kjoehass/firefly/README.md

# firefly

The goal of this project is to develop a device that can simulate the flash patterns of fireflies. The device will be used to investigate evolution and speciation in fireflies.
