kjoehass/firefly/code/README.md

# Arduino sketch

This code was developed using version 1.8.13 of the Arduino IDE.

Set the IDE preferences so that the default sketchbook is this directory.
