kjoehass/firefly/spec/FireflySpec_2p0.tex

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

\graphicspath{{graphics/}}

\ifpdf\pdfinfo{
  /Title (Firefly Simulator Specification) %FIXME
  /Author (Bucknell University) %FIXME
/Keywords () }
\fi

% load hyperref package first!!
\usepackage{fancyhdr,pageslts}
\pagestyle{fancy}
\fancyhf{}
\fancyhead[L]{Firefly Simulator Specification V2.0}
\fancyfoot[C]{Page \thepage\ of \pageref*{LastPage}}
\usepackage[iso]{datetime}
\fancyfoot[L]{Revised \today}
\pagenumbering{arabic}
\renewcommand\headrulewidth{0pt}

\begin{document}
\section{Overview}

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

\section{References}

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

\section{Definitions}

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

\setlength\extrarowheight{4pt}
\begin{supertabular}{p{1.25in}p{5.25in}}
abort &
    A pushbutton input to the \textit{firefly simulator}. Pressing this button
    causes the simulator to stop any repeated \textit{flashes} or
    \textit{patterns}, and to bring the \textit{illumination level} to 0\% on
    all \textit{channels}.\\
ASCII &
    The American Standard Code for Information Interchange. The letters in
    the English alphabet, the decimal digits, and common punctuation marks are
    assigned a unique 7-bit binary code.\\
channel &
    The \textit{channel} of an \textit{LED} is an integer that specifies
    which physical output connector of the firefly simulator is connected
    to the physical LED. The value of \textit{channel} is an integer and
    shall not be less than 1 and not greater than \textit{max channel}.\\
        &
    Note that the \textit{channel} is not the pin number of any particular
    microcontroller. An implementation of the firefly simulator must perform
    the appropriate mapping of an \textit{LED}'s \textit{channel} to an
    appropriate physical pin on the output device.\\
%delay step&
%    A time interval in a \textit{pattern} when all \textit{LEDs} are dark.
%    A \textit{delay step} is a step in a \textit{pattern} that inserts a time
%    delay but does not cause a flash.\\
down duration & 
    The length of the \textit{ramp down} interval. The \textit{down duration}
    is equal to $t_4 - t_3$, as shown in Fig.\ \ref{fig:FlashPulse}. The
    \textit{down duration} shall be a non-negative integer value with units
    of milliseconds. The value of \textit{down duration} shall not be less
    than 0 or greater than 32\,767.\\
%duty factor &  For a periodic rectangular pulse that has only two possible
%    voltage levels, the \textit{duty factor} is the ratio of the duration of
%    the pulse at its higher voltage divided by the period of the waveform.
%
%    \[ 0.0 \le d_f \le 1.0 \quad \mathrm{ or } \quad 0\% \le d_f \le 100\%\]
event &
    An external event that can be recognized by the \textit{firefly simulator}.
    Details TBD.\\
flash &
    The process of bringing the \textit{illumination level} of an \textit{LED}
    from 0\% to 100\% then back to 0\% illumination. A \textit{flash} consists of
    a \textit{ramp up}, followed by an \textit{on time}, followed by a
    \textit{ramp down}. A \textit{flash} begins at $t_1$ and ends at $t_4$,
    as shown in Fig.\ \ref{fig:FlashPulse}. The interval from $t_1$ to $t_2$
    is the \textit{ramp up}. The interval from $t_2$ to $t_3$ is the \textit{on
    time}.  The interval from $t_3$ to $t_4$ is the \textit{ramp down}. The
    interval from $t_4$ to $t_5$ is the \textit{interpulse interval}.\\
    &
    Note the definition of a \textit{flash} primarily specifies the
    \textit{timing} behavior of the \textit{flash}. The selection of a specific
    physical LED and its \textit{max brightness} are part of the definition
    of an \textit{LED}.\\
flash pattern interval &
    The total time duration of a \textit{pattern}.
    This interval includes the time of all \textit{flashes} in the pattern
    as well as the subsequent time when there are no flashes, as shown in
    Fig.\ \ref{fig:PatternTimeline}. The
    \textit{flash pattern interval} is a parameter of a \textit{pattern}.\\
illumination level &
    The brightness of an \textit{LED} at any given point in time, as a
    percentage of that \textit{LED}'s \textit{max brightness}. The
    \textit{illumination level} and \textit{max brightness} values
    indirectly translate to the average current passing through the physical
    LED.\\
    &
    At any given point in time, the average current for an LED is
\[ I_{AVG} = \frac{illumination\,level}{100} \times \frac{max\,brightness}{100}
\times I_{max}\]\\
interpulse interval &
    The total time duration of a \textit{flash}. This interval includes the
    time when the \textit{LED} is illuminated as well as the subsequent time
    when the \textit{LED} is not illuminated, from $t_1$ to $t_5$ in
    Fig.\ \ref{fig:FlashPulse}. The \textit{interpulse interval} is a parameter
    of a \textit{flash}.\\
message &  A sequence of \textit{message fields}, separated by the
    ASCII comma character (decimal 44) and terminated by either the ASCII Line
    Feed (decimal 10), the ASCII Carriage Return (decimal 13), or both the Line
    Feed and the Carriage Return. There shall not be a comma before the first
    field in a message nor after the last field.\\
message field &  A sequence of one or more ASCII characters from the set of
    letters (\texttt{A} through \texttt{Z} and \texttt{a} through \texttt{z}),
    decimal digits (\texttt{0} through \texttt{9}), and the punctuation
    characters required for a \textit{timestamp} (colon, minus, plus, period).
    A message field shall not include a comma.\\
max brightness & 
    The maximum duty factor of the \textit{pulse-width modulation} signal that
    controls the \textit{illumination level} of an \textit{LED}. The
    \textit{max brightness} is a characteristic of an \textit{LED}. The
    value of \textit{max brightness} is an integer and shall be not less
    than 1 and not greater than 100.\\
max channel & 
    The number of physical \textit{LED} \textit{channels} available on a
    particular implementation of a \textit{firefly simulator}.
    The value of \textit{max channel} shall not be less than 1 or greater
    than 127 for any implementation of a \textit{firefly simulator}.\\
max event &
    The number of unique \textit{event} configurations available on a
    particular implementation of a \textit{firefly simulator}.
    The value of \textit{max event} shall not be less than 0 or greater
    than 127 for any implementation of a \textit{firefly simulator}.\\
max flash & 
    The number of unique \textit{flash} configurations available on a
    particular implementation of a \textit{firefly simulator}.
    The value of \textit{max flash} shall not be less than 1 or greater
    than 127 for any implementation of a \textit{firefly simulator}.\\
max LED & 
    The number of unique \textit{LED} configurations available on a
    particular implementation of a \textit{firefly simulator}.
    The value of \textit{max LED} shall not be less than 1 or greater
    than 127 for any implementation of a \textit{firefly simulator}.\\
max pattern & 
    The number of unique \textit{pattern} configurations available on a
    particular implementation of a \textit{firefly simulator}.
    The value of \textit{max pattern} shall not be less than 1 or greater
    than 127 for any implementation of a \textit{firefly simulator}.\\
on duration &
    The length of the \textit{on time} interval. The \textit{on duration} is
    equal to $t_3 - t_2$, as shown in Fig.\ \ref{fig:FlashPulse}. The value
    of \textit{on duration} shall be a positive, non-zero integer with units
    of milliseconds. The value of \textit{on duration} shall not be less than 1
    or greater than 32\,767.\\
on time &
    The period of time during a \textit{flash} when the \textit{LED} is
    constantly at an illumination level of 100\%.\\
pattern &
    A sequence of up to 16 \textit{flashes}, possibly followed by a period
    of time where there are no \textit{flashes}.
    Note that the definition of a \textit{pattern} specifies only the sequence
    of \textit{flashes} that should occur as well as the total duration of the
    \textit{pattern}.\\
%pulse-width modulation & 
ramp down &
    The process of linearly decreasing the \textit{illumination level} of an
    \textit{LED} from 100\% to 0\%.\\
ramp up &
    The process of linearly increasing the \textit{illumination level} of an
    \textit{LED} from 0\% to 100\%.\\
time stamp &
    A representation of the current date and time used as \textit{message field}.
    The \textit{time stamp} shall conform to ISO 8601. The format of the
    \textit{time stamp} is TBD.\\
up duration &
    The length of the \textit{ramp up} interval. The \textit{up duration}
    is equal to $t_2 - t_1$, as shown in Fig.\ \ref{fig:FlashPulse}. The
    value of \textit{up duration} shall be a non-negative integer with units
    of milliseconds. The value of \textit{up duration} shall not be less than
    0 or greater than 32\,767.\\
\end{supertabular}

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

\section{Resolution and Accuracy}

\subsection{Brightness}

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

\subsection{Time}

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

\section{Configuration Messages}

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

\subsection{\textit{capacity query/capacity response messages}}

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

    & Unique identifier for this message type
    & This field shall contain the lowercase letter '\texttt{c}'.
    \\ \hline
    2            & \textit{time stamp}
    & The current data and time
    & This field is TBD
    \\ \hline
    3            & temperature
    & The current ambient temperature, in degrees Celsius.
    & This field shall contain a decimal integer from 0 to 127.
    \\ \hline
    4            & \textit{max channel}
    & The number of physical LEDs available
    & This field shall contain a decimal integer from 1 to 127.
    \\ \hline
    5            & \textit{max LED}
    & The number of available \textit{LED} definitions
    & This field shall contain a decimal integer from 1 to 127.
    \\ \hline
    6            & \textit{max flash}
    & The number of available \textit{flash} definitions
    & This field shall contain a decimal integer from 1 to 127.
    \\ \hline
    7            & \textit{max event}
    & The number of available \textit{event} definitions
    & This field shall contain a decimal integer from 1 to 127.
    \\ \hline
    8            & \textit{max pattern}
    & The number of available \textit{pattern} definitions
    & This field shall contain a decimal integer from 1 to 127.
    \\ \hline
  \end{tabular}
  \label{tab:CapacityResponse}
\end{table}

\subsection{\textit{LED configuration message}}

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

\subsection{\textit{flash configuration message}}

An \textit{flash configuration message} is sent from the host computer to the
firefly simulator. This message provides the parameters for a single
\textit{flash} of an \textit{LED}, as shown in Table \ref{tab:FlashConfig}.

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

\subsection{\textit{pattern configuration message}}

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

A \textit{pattern} may contain from 1 to 16 flashes. Therefore, field 4 in the
\textit{pattern configuration message} may be repeated to define
the desired \textit{flashes} in the pattern. If the \textit{pattern
configuration message} specifies fewer than 16 \textit{flashes} then the
unspecified \textit{flashes} shall have a default \textit{flash} number of 0
(zero) and will be ignored during execution of the \textit{pattern}.

As an example, the message below could be sent by the host computer in
order to configure the \textit{pattern} shown in Fig.\
\ref{fig:PatternTimeline}. This particular pattern was arbitrarily designated
as pattern 5. It contains four \textit{flashes}, but one of the previously
defined \textit{flashes} was repeated. The total duration of this pattern
(i.e.\ the \textit{flash pattern interval}) is \SI{10}{\second}.\\[12pt]
{\ttfamily
P,5,10000,1,4,7,1\\
}

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

\section{Command and Response Messages}

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

Once the \textit{firefly simulator} has received and started executing a
command message it will not respond to any messages sent by the host computer.
Every command must be terminated by pressing the \textit{abort} button before
the \textit{firefly simulator} will respond to messages from the host computer.

\subsection{\textit{Execute LED message}}

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

\subsection{\textit{Execute flash message}}

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

\subsection{\textit{Execute pattern message}}

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

The \textit{firefly simulator} shall respond to the \textit{execute pattern
message} by sending a \textit{pattern start message} to the host computer,
as shown in Table \ref{tab:PatternStart}. The \textit{pattern start message}
shall be sent when every occurrence of a pattern begins.

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

    & Unique identifier for this message type
    & This field shall contain the lowercase letter '\texttt{p}'.
    \\ \hline
    2            & \textit{time stamp}
    & The current data and time
    & This field is TBD
    \\ \hline
    3            & temperature
    & The current ambient temperature, in degrees Celsius.
    & This field shall contain a decimal integer from 0 to 127.
    \\ \hline
    4            & \textit{pattern}

    & The \textit{pattern} number of the pattern that will be executed.
    & This field shall contain a decimal integer from 1 to 127.
    \\ \hline
  \end{tabular}
  \label{tab:PatternStart}
\end{table}

\subsection{\textit{Execute random pattern message}}

An \textit{Execute random pattern message} is sent from the host computer to the
\textit{firefly simulator}. This message can be used to cause the simulator to
pseudo-randomly select and execute patterns from the set of TBD.

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

\subsection{\textit{Event response message}}

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

    & Unique identifier for this message type
    & This field shall contain the lowercase letter '\texttt{e}'.
    \\ \hline
    2            & \textit{time stamp}
    & The current data and time
    & This field is TBD
    \\ \hline
    3            & temperature
    & The current ambient temperature, in degrees Celsius.
    & This field shall contain a decimal integer from 0 to 127.
    \\ \hline
    4            & \textit{pattern}

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

\section{Revision History}

From version 1.0 to version 2.0:
\begin{compactitem}
  \item Added ISO 8601 to references
  \item Added definitions of terms \textit{abort}, \textit{flash pattern
    interval}, \textit{interpulse interval}, \textit{max event},
    \textit{max LED}, \textit{time stamp}
  \item The term \textit{blink} is replaced with the term \textit{flash}.
  \item Added \textit{time stamp} and \textit{temperature} fields to the
    \textit{capacity response message}
  \item Added examples of typical messages
  \item Definition and configuration message for \textit{pattern} was
    significantly changed.
  \item Removed the repeat count field from all \textit{execute} commands;
    these commands must now be terminated by the \textit{abort} 
  \item Updated diagram of \textit{flash} timing to include \textit{interpulse
        interval}.
  \item Updated diagram of \textit{pattern} timing to include \textit{flash
        pattern interval}.
  \item Added definition of \textit{start pattern message}.
\end{compactitem}
\end{document}
