kjoehass/firefly/spec/FireflySpec_2p0.pdf

Firefly Simulator Specification V2.0

## 1 Overview

This document provides specifications for a firefly simulator. This device is intended to simulate the light displays of common fireflies, such as Photinus pyralis. The firefly simulator will provide means to control the brightness, duration, and other relevant parameters of the simulated light display. Light-emitting diodes (LEDs) will be used as the light source, and the color of the display can be altered by connecting different LED types to the simulator.
The firefly simulator can be configured via commands issued to it from a host computer, as shown in Fig. 1. The physical link between the host computer and the firefly simulator is an asynchronous serial communications interface, which can be accomplished with a common and inexpensive USB adapter. The firefly simulator also can return status information to the host computer via the same interface.
Once configured, the firefly simulator can be used in a stand-alone mode, without requiring a connection to a host computer. Pushbuttons on the firefly simulator can be used to activate light displays that were previously configured. When in the stand-alone mode, the simulator can be powered by a USB powerbank.

Fire y Simulator; Host; LEDs; Computer; Pushbuttons; Test Specimen; USB

Figure 1: Firefly Simulator Block Diagram

This document describes the minimum required functionality of the firefly simulator. Possible future enhancements to the simulator include:
- The ability to sense the behavior of a test specimen and use that behavior to modify the parameters of a light display.
- The ability to record information about simulator activity on non-volatile memory, such as a removable Secure Digital (SD) memory card.
- The addition of a real-time clock (RTC) to the firefly simulator so that timestamps can be added to response messages from the simulator to the host computer.

## 2 References

1. IEEE Standard for Transitions, Pulses, and Related Waveforms, IEEE Standard 181, 2011.
2. Data elements and interchange formats – Information interchange – Representation of dates and times, ISO 8601

## 3 Definitions

abort | A pushbutton input to the firefly simulator. Pressing this button causes the simulator to stop any repeated flashes or patterns, and to bring the illumination level to 0% on all channels.
Revised 2019-02-07 | Page 1 of 9

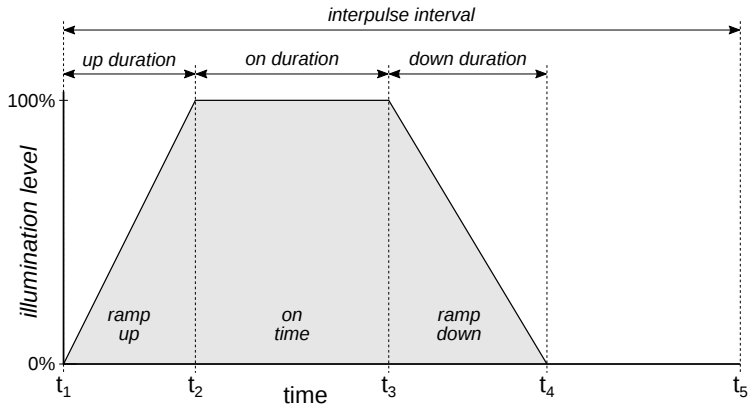
[picture p10: figure]
0%illumination level; time; ramp up; on time; ramp down; up duration; on duration; down duration; interpulse interval

Figure 2: flash waveform

ASCII | The American Standard Code for Information Interchange. The letters in the English alphabet, the decimal digits, and common punctuation marks are assigned a unique 7-bit binary code.
channel | The channel of an LED is an integer that specifies which physical output connector of the firefly simulator is connected to the physical LED. The value of channel is an integer and shall not be less than 1 and not greater than max channel.
| Note that the channel is not the pin number of any particular microcontroller. An imple- mentation of the firefly simulator must perform the appropriate mapping of an LED’s channel to an appropriate physical pin on the output device.
down duration | The length of the ramp down interval. The down duration is equal to t4 −t3, as shown in Fig. 2. The down duration shall be a non-negative integer value with units of mil- liseconds. The value of down duration shall not be less than 0 or greater than 32 767.
event | An external event that can be recognized by the firefly simulator. Details TBD.
flash | The process of bringing the illumination level of an LED from 0% to 100% then back to 0% illumination. A flash consists of a ramp up, followed by an on time, followed by a ramp down. A flash begins at t1 and ends at t4, as shown in Fig. 2. The interval from t1 to t2 is the ramp up. The interval from t2 to t3 is the on time. The interval from t3 to t4 is the ramp down. The interval from t4 to t5 is the interpulse interval.
| Note the definition of a flash primarily specifies the timing behavior of the flash. The selection of a specific physical LED and its max brightness are part of the definition of an LED.
flash pattern interval | The total time duration of a pattern. This interval includes the time of all flashes in the pattern as well as the subsequent time when there are no flashes, as shown in Fig. 3. The flash pattern interval is a parameter of a pattern.
illumination level | The brightness of an LED at any given point in time, as a percentage of that LED’s max brightness. The illumination level and max brightness values indirectly translate to the average current passing through the physical LED.
| At any given point in time, the average current for an LED is

IAV G =

illuminationlevel
100

×

max brightness
100

×Imax

interpulse interval | The total time duration of a flash. This interval includes the time when the LED is illuminated as well as the subsequent time when the LED is not illuminated, from t1 to t5 in Fig. 2. The interpulse interval is a parameter of a flash.
message | A sequence of message fields, separated by the ASCII comma character (decimal 44) and terminated by either the ASCII Line Feed (decimal 10), the ASCII Carriage Return (decimal 13), or both the Line Feed and the Carriage Return. There shall not be a comma before the first field in a message nor after the last field.
message field | A sequence of one or more ASCII characters from the set of letters (A through Z and a through z), decimal digits (0 through 9), and the punctuation characters required for a timestamp (colon, minus, plus, period). A message field shall not include a comma.
max brightness | The maximum duty factor of the pulse-width modulation signal that controls the illu- mination level of an LED. The max brightness is a characteristic of an LED. The value of max brightness is an integer and shall be not less than 1 and not greater than 100.
max channel | The number of physical LED channels available on a particular implementation of a firefly simulator. The value of max channel shall not be less than 1 or greater than 127 for any implementation of a firefly simulator.
max event | The number of unique event configurations available on a particular implementation of a firefly simulator. The value of max event shall not be less than 0 or greater than 127 for any implementation of a firefly simulator.
max flash | The number of unique flash configurations available on a particular implementation of a firefly simulator. The value of max flash shall not be less than 1 or greater than 127 for any implementation of a firefly simulator.
max LED | The number of unique LED configurations available on a particular implementation of a firefly simulator. The value of max LED shall not be less than 1 or greater than 127 for any implementation of a firefly simulator.
max pattern | The number of unique pattern configurations available on a particular implementation of a firefly simulator. The value of max pattern shall not be less than 1 or greater than 127 for any implementation of a firefly simulator.
on duration | The length of the on time interval. The on duration is equal to t3−t2, as shown in Fig. 2. The value of on duration shall be a positive, non-zero integer with units of milliseconds. The value of on duration shall not be less than 1 or greater than 32 767.
on time | The period of time during a flash when the LED is constantly at an illumination level of 100%.
pattern | A sequence of up to 16 flashes, possibly followed by a period of time where there are no flashes. Note that the definition of a pattern specifies only the sequence of flashes that should occur as well as the total duration of the pattern.
ramp down | The process of linearly decreasing the illumination level of an LED from 100% to 0%.
ramp up | The process of linearly increasing the illumination level of an LED from 0% to 100%.
time stamp | A representation of the current date and time used as message field. The time stamp shall conform to ISO 8601. The format of the time stamp is TBD.
up duration | The length of the ramp up interval. The up duration is equal to t2 −t1, as shown in Fig.
2. The value of up duration shall be a non-negative integer with units of milliseconds.
| The value of up duration shall not be less than 0 or greater than 32 767.

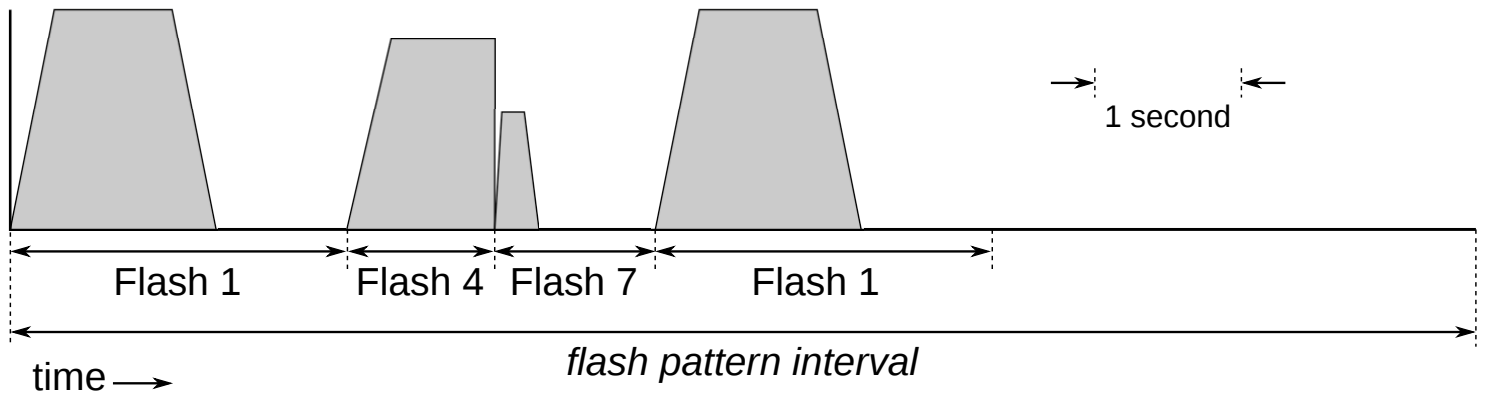
[picture p11: figure]
time; Flash 1; flash pattern interval; Flash 4 Flash 7; 1 second

Figure 3: Example pattern timeline

## 4 Resolution and Accuracy

### 4.1 Brightness

The firefly simulator does not directly control the brightness of a physical LED. Instead, the simulator controls the average current provided to the LED. The simulator’s configuration messages allow the actual average current (IAV G) of an LED to be specified with a resolution of ±1% of the maximum available current (IMAX ). The maximum available current, and the precision which with the current can be specified, will be determined by the circuitry associated with a given physical LED and need not be the same for all LEDs.

### 4.2 Time

Values that represent time shall have units of milliseconds and a resolution of 1 ms. The accuracy of all pulse durations and time delays generated by the firefly simulator over an interpulse interval shall have a maximum error of ±10 ms. The cumulative timing error over a flash pattern interval shall not exceed 200 ms.

## 5 Configuration Messages

The firefly simulator is configured via a serial communications interface to a host computer. The host computer can set the values of all parameters for LEDs, flashes, and patterns. A unique configuration message format is specified for configuring an LED, configuring a flash, or configuring a pattern.

### 5.1 capacity query/capacity response messages

The capacity query message can be used by the host computer to determine the capabilities of a firefly simulator.

Table 1: Definition of the capacity query message
Field Number | Field Name | Description | Format
1 | Header | Unique first character for an capacity query message | This field shall be the uppercase letter ‘C’.

The firefly simulator will respond to the capacity query message by sending a capacity response message to the host computer.

Table 2: Definition of the capacity response message
Field Number | Field Name | Description | Format
1 | message type | Unique identifier for this message type | This field shall contain the lowercase letter ’c’.
2 | time stamp | The current data and time | This field is TBD
3 | temperature | The current ambient temperature, in degrees Celsius. | This field shall contain a decimal in-teger from 0 to 127.
4 | max channel | The number of physical LEDs avail-able | This field shall contain a decimal in-teger from 1 to 127.
5 | max LED | The number of available LED defini-tions | This field shall contain a decimal in-teger from 1 to 127.
6 | max flash | The number of available flash defini-tions | This field shall contain a decimal in-teger from 1 to 127.
7 | max event | The number of available event defini-tions | This field shall contain a decimal in-teger from 1 to 127.
8 | max pattern | The number of available pattern def-initions | This field shall contain a decimal in-teger from 1 to 127.

### 5.2 LED configuration message

An LED configuration message is sent from the host computer to the firefly simulator. Every LED configuration message shall contain four message fields, as shown in Table 3.
As an example, the three messages below could be sent by the host computer in order to configure three LEDs. This example assumes that LED 2 uses physical channel 1 and has a max brightness of 100%. LEDs 3 and 5 use the same physical channel (i.e. the same physical LED) but with different levels of max brightness: 87% and 53%, respectively. The LED numbers, channel numbers, and max brightness levels shown here were chosen arbitrarily; the purpose of this example is only to illustrate the syntax of the LED configuration message.

L,2,1,100
L,3,6,87
L,5,6,53

Table 3: Definition of the LED configuration message
Field Number | Field Name | Description | Format
1 | Header | Unique first character for an LED configuration message | This field shall be the uppercase letter ‘L’.
2 | LED number | A unique identifier for each LED def-inition | This field shall contain a decimal in-teger from 1 to max LED.
3 | LED channel | The physical channel associated with this LED | This field shall contain a decimal in-teger from 1 to max channel.
4 | max brightness | The maximum brightness level for the LED | This field shall contain a decimal in-teger from 1 to 100.

### 5.3 flash configuration message

An flash configuration message is sent from the host computer to the firefly simulator. This message provides the parameters for a single flash of an LED, as shown in Table 4.
As an example, the three messages below could be sent by the host computer in order to configure the three flashes shown in Fig. 3. This example assumes that flash 1 uses LED 2, flash 4 uses LED 3, and flash 7 uses LED 5. The flash and LED numbers were chosen arbitrarily; the purpose of this example is only to illustrate the syntax of the flash configuration message.

F,1,2,300,800,300,2300
F,4,3,300,700,0,1000
F,7,5,50,150,100,1100

Table 4: Definition of the flash configuration message
Field Number | Field Name | Description | Format
1 | Header | Unique first character for a flash con-figuration message | This field shall be the uppercase letter ‘F’.
2 | flash number | A unique identifier for each flash def-inition | This field shall contain a decimal in-teger from 1 to max flash.
3 | LED number | Identifier for the LED to be illumi-nated in this flash | This field shall contain a decimal in-teger from 1 to max channel.
4 | up duration | The duration of the ramp up in mil-liseconds | This field shall contain a decimal in-teger from 0 to 32 767.
5 | on duration | The duration of the on time in mil-liseconds | This field shall contain a decimal in-teger from 1 to 32 767.
6 | down duration | The duration of the ramp down in milliseconds | This field shall contain a decimal in-teger from 0 to 32 767.
7 | interpulse inter-val | The duration of the entire flash in milliseconds | This field shall contain a decimal in-teger from 0 to 32 767.

### 5.4 pattern configuration message

An pattern configuration message is sent from the host computer to the firefly simulator. This message provides the parameters for a single pattern of one or more flashes, as shown in Table 5. Note that the same flash may be repeated within a pattern.
A pattern may contain from 1 to 16 flashes. Therefore, field 4 in the pattern configuration message may be repeated to define the desired flashes in the pattern. If the pattern configuration message specifies fewer than 16 flashes then the unspecified flashes shall have a default flash number of 0 (zero) and will be ignored during execution of the pattern.
As an example, the message below could be sent by the host computer in order to configure the pattern shown in Fig. 3. This particular pattern was arbitrarily designated as pattern 5. It contains four flashes, but one of the previously defined flashes was repeated. The total duration of this pattern (i.e. the flash pattern interval) is 10 s.

P,5,10000,1,4,7,1

Table 5: Definition of the pattern configuration message
Field Number | Field Name | Description | Format
1 | Header | Unique first character for a pattern configuration message | This field shall be the uppercase letter ‘P’.
2 | pattern number | A unique identifier for each pattern definition | This field shall be a decimal integer from 1 to max pattern.
3 | flash pattern in-terval number | The total duration of the pattern in milliseconds | This field shall contain a decimal in-teger from 0 to 32 767.
4 | flash list | The number of a flash to be included in the pattern. | This field shall be a decimal integer from 1 to max flash.

## 6 Command and Response Messages

The host computer can command the firefly simulator to turn on an LED at a specified illumination level, repeatedly execute a specific flash, repeatedly execute a specific pattern, or repeatedly execute a set of available patterns in a pseudorandom order.
Once the firefly simulator has received and started executing a command message it will not respond to any messages sent by the host computer. Every command must be terminated by pressing the abort button before the firefly simulator will respond to messages from the host computer.

### 6.1 Execute LED message

An Execute LED message is sent from the host computer to the firefly simulator. This message can be used to turn an LED on for testing or calibration purposes. Every Execute LED message shall contain three message fields, as shown in Table 6.

Table 6: Definition of the Execute LED message
Field Number | Field Name | Description | Format
1 | Header | Unique first two characters for an Ex-ecute LED message | This field shall be the uppercase let-ters ‘XL’.
2 | LED channel | A unique identifier for a physical LED | This field shall contain a decimal in-teger from 1 to max channel.
3 | illumination level | Sets a constant value for the illumi-nation level of the LED | This field shall contain a decimal in-teger from 0 to 100. A value of 100 causes the illumination level of the LED to be set at a constant value of 100% (of the LED’s max brightness level). A ‘0’ shall cause the illumina-tion level of the LED to be set at 0% (completely dark).

### 6.2 Execute flash message

An Execute flash message is sent from the host computer to the firefly simulator. This message can be used to cause the firefly simulator to repeatedly execute a specific flash. Every Execute flash message shall contain two message fields, as shown in Table 7.

Table 7: Definition of the Execute flash message
Field Number | Field Name | Description | Format
1 | Header | Unique first two characters for an Ex-ecute flash message | This field shall be the uppercase let-ters ‘XF’.
2 | flash number | A unique identifier for a flash | This field shall contain a decimal in-teger from 1 to max flash.

### 6.3 Execute pattern message

An Execute pattern message is sent from the host computer to the firefly simulator. This message can be used to cause the firefly simulator to repeatedly execute a specific pattern. Every Execute pattern message shall contain two message fields, as shown in Table 8.

Table 8: Definition of the Execute pattern message
Field Number | Field Name | Description | Format
1 | Header | Unique first two characters for an Ex-ecute pattern message | This field shall be the uppercase let-ters ‘XP’.
2 | pattern number | A unique identifier for a pattern | This field shall contain a decimal in-teger from 1 to max pattern.

The firefly simulator shall respond to the execute pattern message by sending a pattern start message to the host computer, as shown in Table 9. The pattern start message shall be sent when every occurrence of a pattern begins.

Table 9: Definition of the pattern start message
Field Number | Field Name | Description | Format
1 | message type | Unique identifier for this message type | This field shall contain the lowercase letter ’p’.
2 | time stamp | The current data and time | This field is TBD
3 | temperature | The current ambient temperature, in degrees Celsius. | This field shall contain a decimal in-teger from 0 to 127.
4 | pattern | The pattern number of the pattern that will be executed. | This field shall contain a decimal in-teger from 1 to 127.

### 6.4 Execute random pattern message

An Execute random pattern message is sent from the host computer to the firefly simulator. This message can be used to cause the simulator to pseudo-randomly select and execute patterns from the set of TBD.

The firefly simulator shall send a pattern start message to the host computer before beginning each pattern.

Table 10: Definition of the Execute random pattern message
Field Number | Field Name | Description | Format
1 | Header | Unique first two characters for an Ex-ecute random pattern message | This field shall be the uppercase let-ters ‘XR’.

### 6.5 Event response message

The firefly simulator shall respond to an event by sending an event response message to the host computer, as shown in Table 11.

Table 11: Definition of the event response message
Field Number | Field Name | Description | Format
1 | message type | Unique identifier for this message type | This field shall contain the lowercase letter ’e’.
2 | time stamp | The current data and time | This field is TBD
3 | temperature | The current ambient temperature, in degrees Celsius. | This field shall contain a decimal in-teger from 0 to 127.
4 | pattern | The event number of the event that occurred. | This field shall contain a decimal in-teger from 1 to 127.

## 7 Revision History

From version 1.0 to version 2.0:
- Added ISO 8601 to references
- Added definitions of terms abort, flash pattern interval, interpulse interval, max event, max LED, time stamp
- The term blink is replaced with the term flash.
- Added time stamp and temperature fields to the capacity response message
- Added examples of typical messages
- Definition and configuration message for pattern was significantly changed.
- Removed the repeat count field from all execute commands; these commands must now be terminated by the abort
- Updated diagram of flash timing to include interpulse interval.
- Updated diagram of pattern timing to include flash pattern interval.
- Added definition of start pattern message.
