kjoehass/firefly/spec/graphics/Flashes_BlinkPulse.pdf

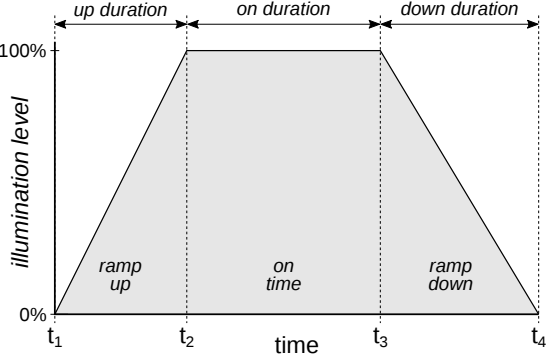
[picture p12: figure]
0%illumination level; time; ramp up; on time; ramp down; up duration; on duration; down duration
