kjoehass/firefly/spec/graphics/Flashes_PatternTimeline.pdf

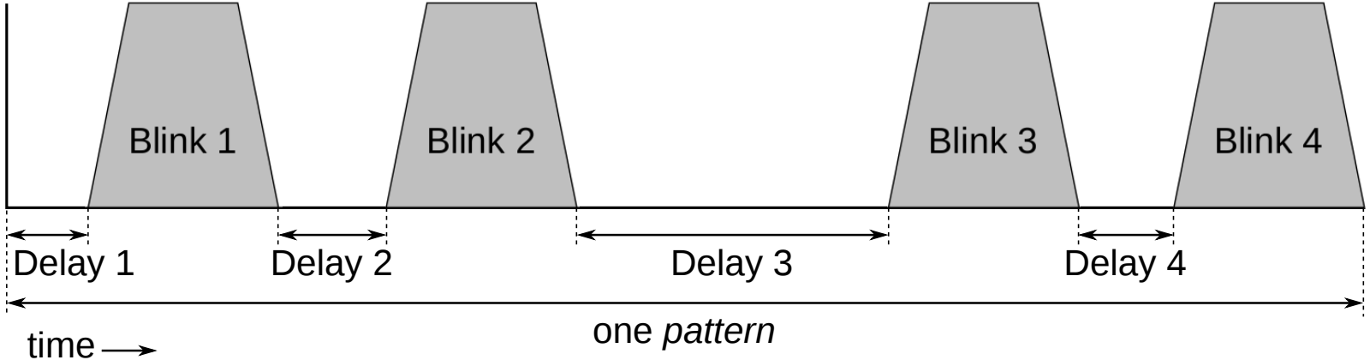
[picture p13: page 1]

time

Delay 1 | Delay 2 | Delay 3 | Delay 4
| | one pattern
