kjoehass/firefly/spec/graphics/Flashes_PatternTimeline2.pdf

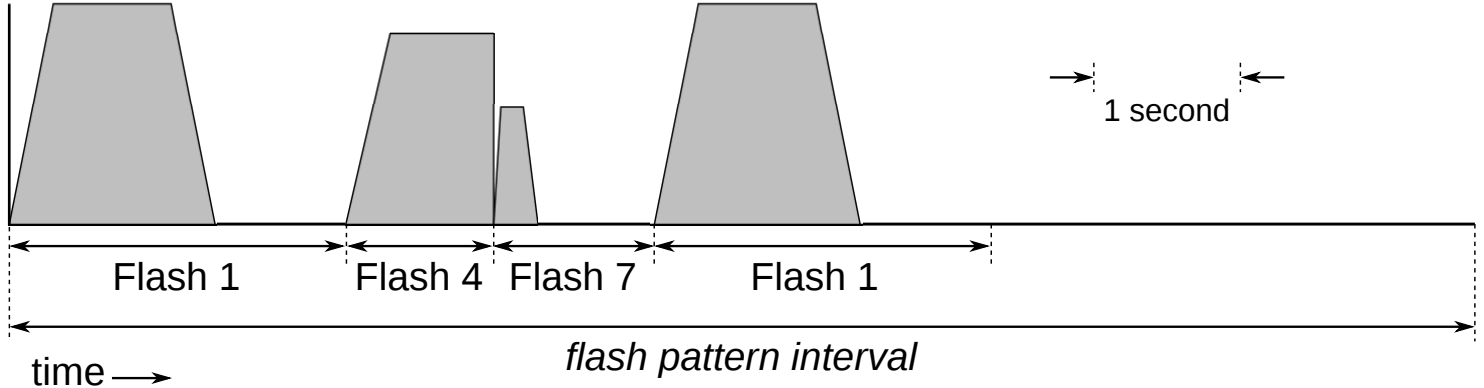
[picture p14: figure]
time; Flash 1; flash pattern interval; Flash 4 Flash 7; 1 second
