kjoehass/firefly/ConstCurrPTH/ConstCurrPTHBottom.png

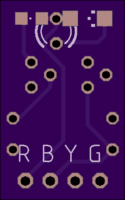
ConstCurrPTH/ConstCurrPTHBottom.png
