kjoehass/firefly/ConstCurrPTH/ConstCurrPTHTop.png

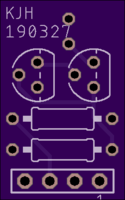
ConstCurrPTH/ConstCurrPTHTop.png
