kjoehass/firefly/spec/graphics/FlashFSM_1.png

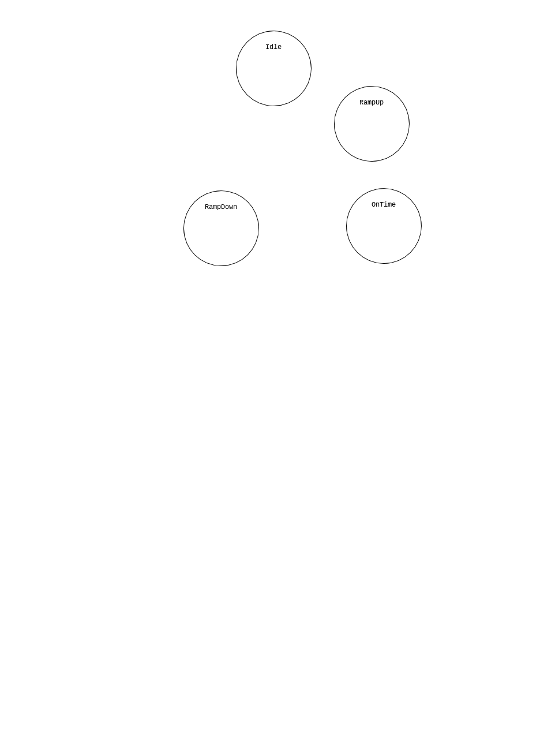
spec/graphics/FlashFSM_1.png
