kjoehass/firefly/spec/graphics/Flashes_BlockDiagram.pdf

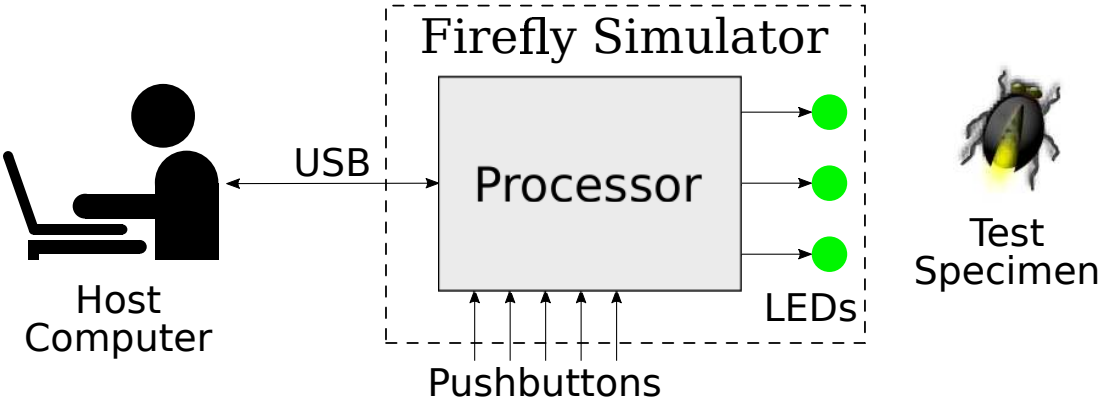
[picture p20: page 1]
Fire y Simulator; Host; LEDs; Computer; Pushbuttons; Test Specimen; USB
