kjoehass/firefly/spec/graphics/Flashes.svgz.pdf

## 0%illumination level

## 0%illumination level

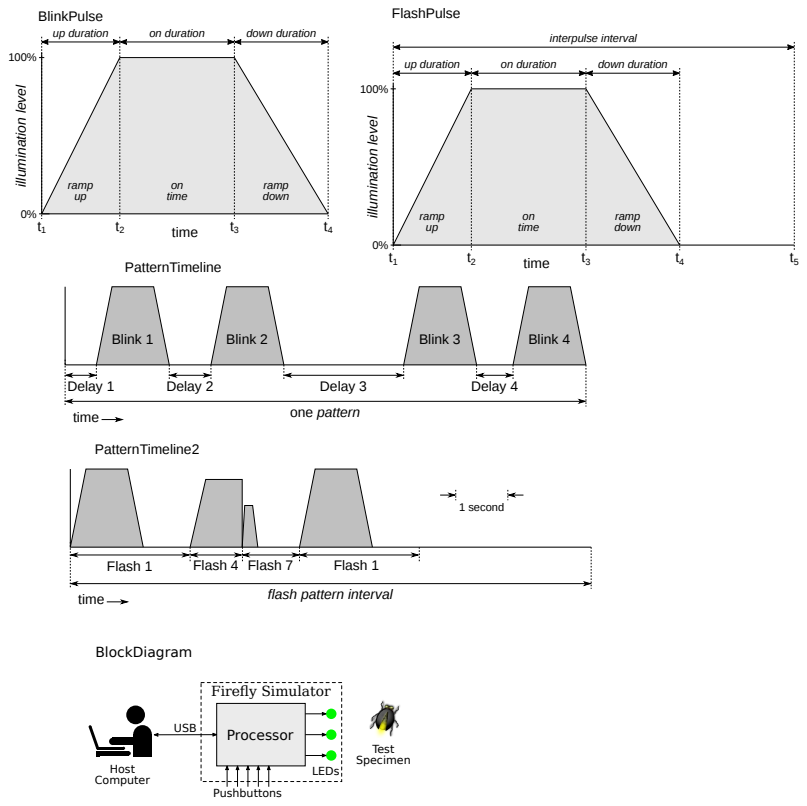
[picture p21: page 1]
BlinkPulse; time; Blink 1; Blink 2; Blink 3; Blink 4; Delay 1; Delay 2; Delay 3; Delay 4; one pattern; PatternTimeline; ramp up; on time; ramp down; up duration; on duration; down duration; Firefly Simulator; LEDs; Processor; Host Computer; Pushbuttons; Test Specimen; USB; BlockDiagram; FlashPulse; interpulse interval; Flash 1; Flash 4 Flash 7; 1 second; PatternTimeline2

flash pattern interval
