kjoehass/firefly/ConstCurrPTH/ConstCurrPTH_V1.brd

## EAGLE design ConstCurrPTH/ConstCurrPTH_V1.brd (2019-05-01)

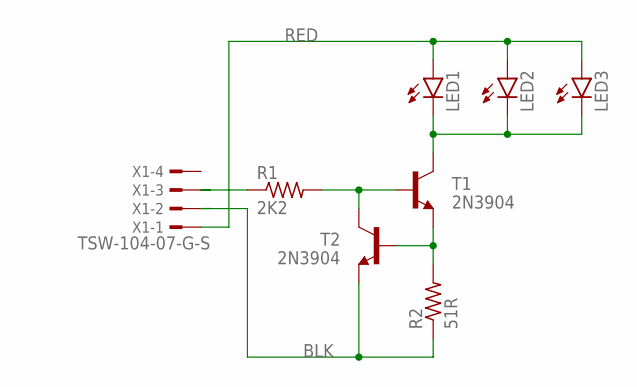
[picture p25: schematic ConstCurrPTH_V1.sch]

Parts:
LED1: LED3MM
LED2: LEDCHIPLED_0805; CHIPLED_0805
LED3: LEDCHIPLED_1206; CHIPLED_1206
R1: 2K2; 0207/10
R2: 51R; 0207/10
T1, T2: 2N3904; TO92
X1: TSW-104-07-G-S; TSW-104-XX-G-S

Connections:
BLK: R2.1, T2.3 (E), X1.2
unnamed: LED1.K (C), LED2.C, LED3.C, T1.1 (C)
unnamed: R2.2, T1.3 (E), T2.2 (B)
unnamed: R1.2, T1.2 (B), T2.1 (C)
unnamed: R1.1, X1.3
RED: LED1.A, LED2.A, LED3.A, X1.1

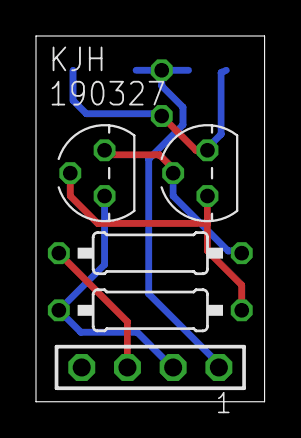
[picture p26: board ConstCurrPTH_V1.brd from above]

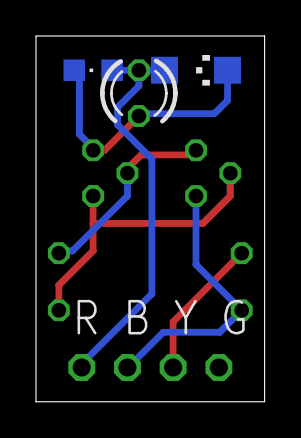
[picture p27: board ConstCurrPTH_V1.brd from below]

Board: 2 copper layers, 12.7 x 20.3 mm, 8 parts (3 on the bottom side), 6 nets.
