kjoehass/firefly/RJ11Breakout/RJ11Breakout.brd

## EAGLE design RJ11Breakout/RJ11Breakout.brd (2019-05-01)

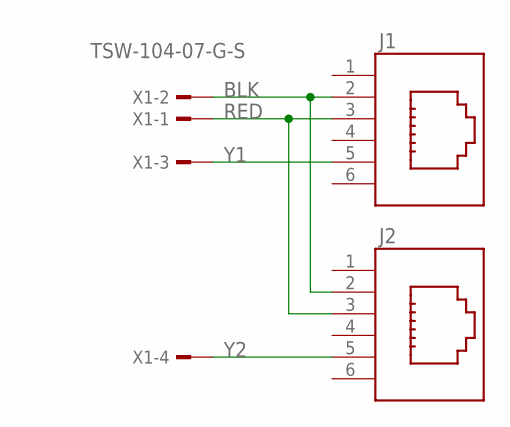
[picture p28: schematic RJ11Breakout.sch]

Parts:
J1, J2: 615006138421
X1: TSW-104-07-G-S; TSW-104-XX-G-S

Connections:
BLK: J1.2 (5), J2.2 (5), X1.2
RED: J1.3 (4), J2.3 (4), X1.1
Y1: J1.5 (2), X1.3
Y2: J2.5 (2), X1.4

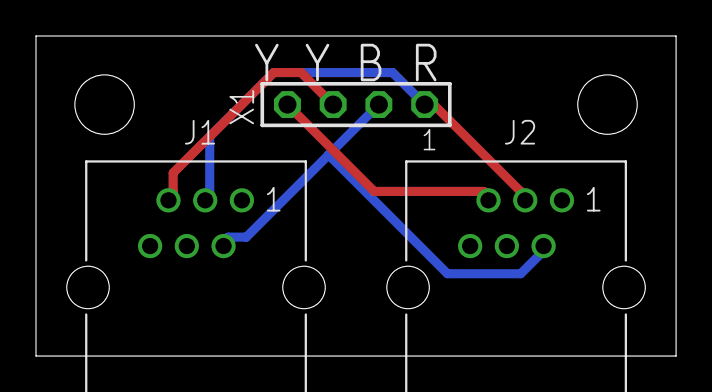
[picture p29: board RJ11Breakout.brd from above]

Board: 2 copper layers, 35.6 x 17.8 mm, 3 parts (0 on the bottom side), 4 nets.
