kjoehass/firefly/FireflyShield/FireflyShield.brd

## EAGLE design FireflyShield/FireflyShield.brd (2019-05-01)

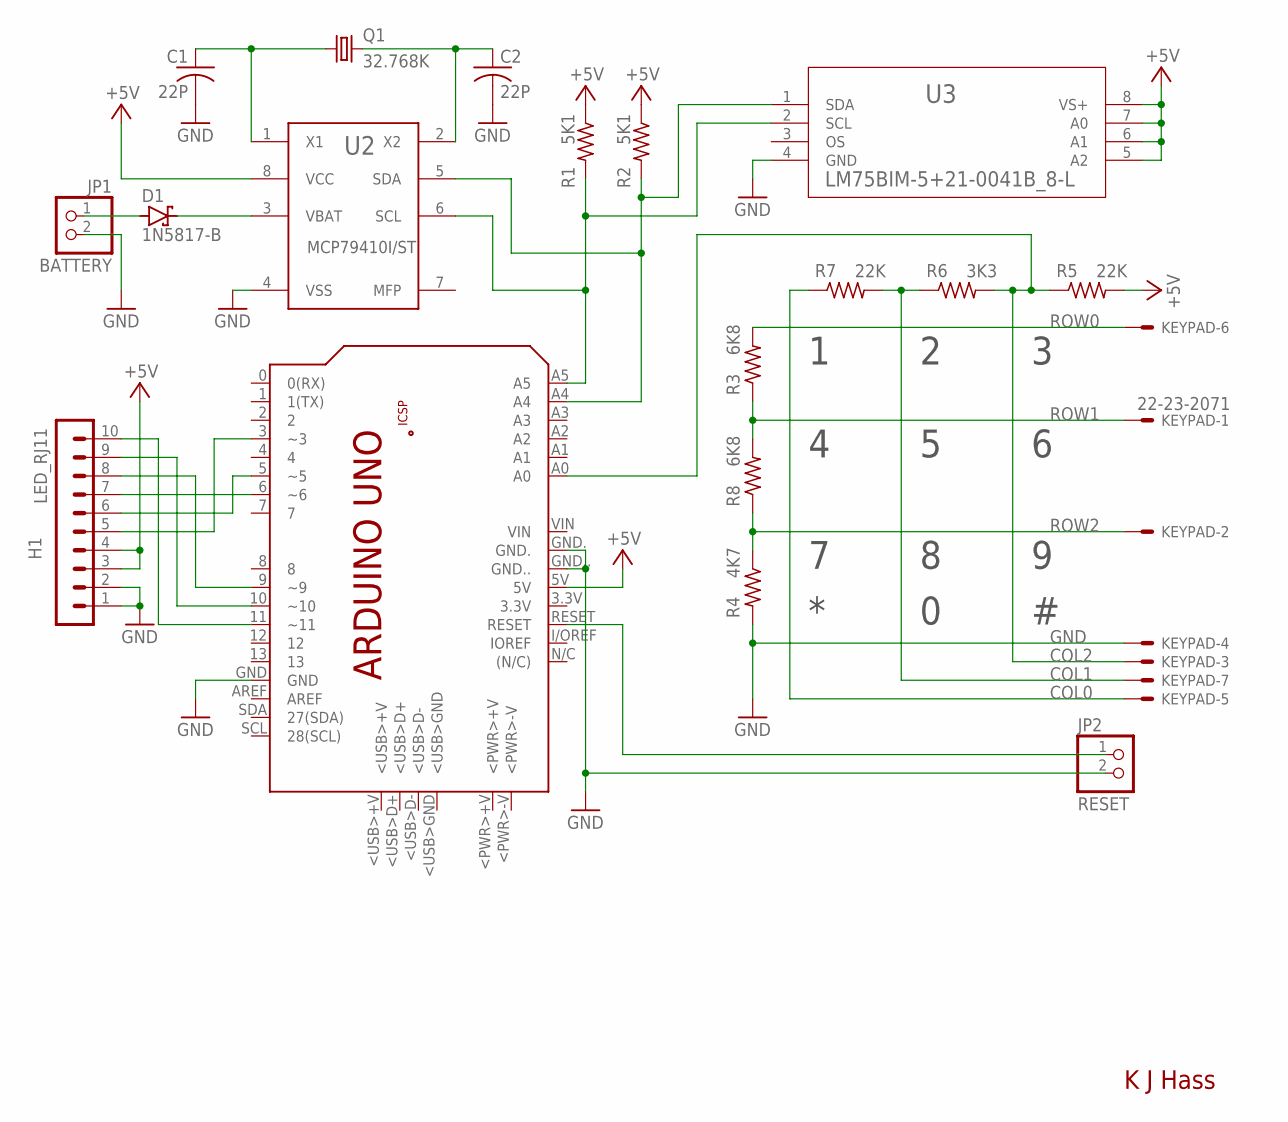
[picture p30: schematic FireflyShield.sch]

Parts:
C1, C2: 22P; C0805
D1: 1N5817-B; DO41-7.6
H1: LED_RJ11; MA10-1
JP1: BATTERY; 1X02
JP2: RESET; 1X02
KEYPAD: 22-23-2071
PCB1: ARDUINO_UNO
Q1: 32.768K; TC26V
R1, R2: 5K1; 0207/10
R3, R8: 6K8; 0207/10
R4: 4K7; 0207/10
R5, R7: 22K; 0207/10
R6: 3K3; 0207/10
U2: MCP79410I/ST; TSSOP8_4MM4
U3: LM75BIM-5+21-0041B_8-L; 21-0041B_8-L

Connections:
+5V: H1.3, H1.4, PCB1.5V, R1.1, R2.1, R5.2, U2.8 (VCC), U3.5 (A2), U3.6 (A1), U3.7 (A0), U3.8 (VS+)
COL0: KEYPAD.5, R7.1
COL1: KEYPAD.7, R6.1, R7.2
COL2: KEYPAD.3, PCB1.A0, R5.1, R6.2
GND: C1.2, C2.2, H1.1, H1.2, JP1.2, JP2.2, KEYPAD.4, PCB1.GND, PCB1.GND., PCB1.GND.., R4.2, U2.4 (VSS), U3.4 (GND)
unnamed: PCB1.A5, R1.2, U2.6 (SCL), U3.2 (SCL)
unnamed: H1.5, PCB1.3 (~3)
unnamed: H1.6, PCB1.5 (~5)
unnamed: H1.7, PCB1.6 (~6)
unnamed: H1.8, PCB1.9 (~9)
unnamed: H1.9, PCB1.10 (~10)
unnamed: H1.10, PCB1.11 (~11)
unnamed: JP2.1, PCB1.RESET
unnamed: C1.1, Q1.1, U2.1 (X1)
unnamed: C2.1, Q1.2, U2.2 (X2)
unnamed: D1.C, U2.3 (VBAT)
unnamed: D1.A, JP1.1
ROW0: KEYPAD.6, R3.2
ROW1: KEYPAD.1, R3.1, R8.2
ROW2: KEYPAD.2, R4.1, R8.1
SCL: PCB1.A4, R2.2, U2.5 (SDA), U3.1 (SDA)

Notes on the sheet:
K J Hass

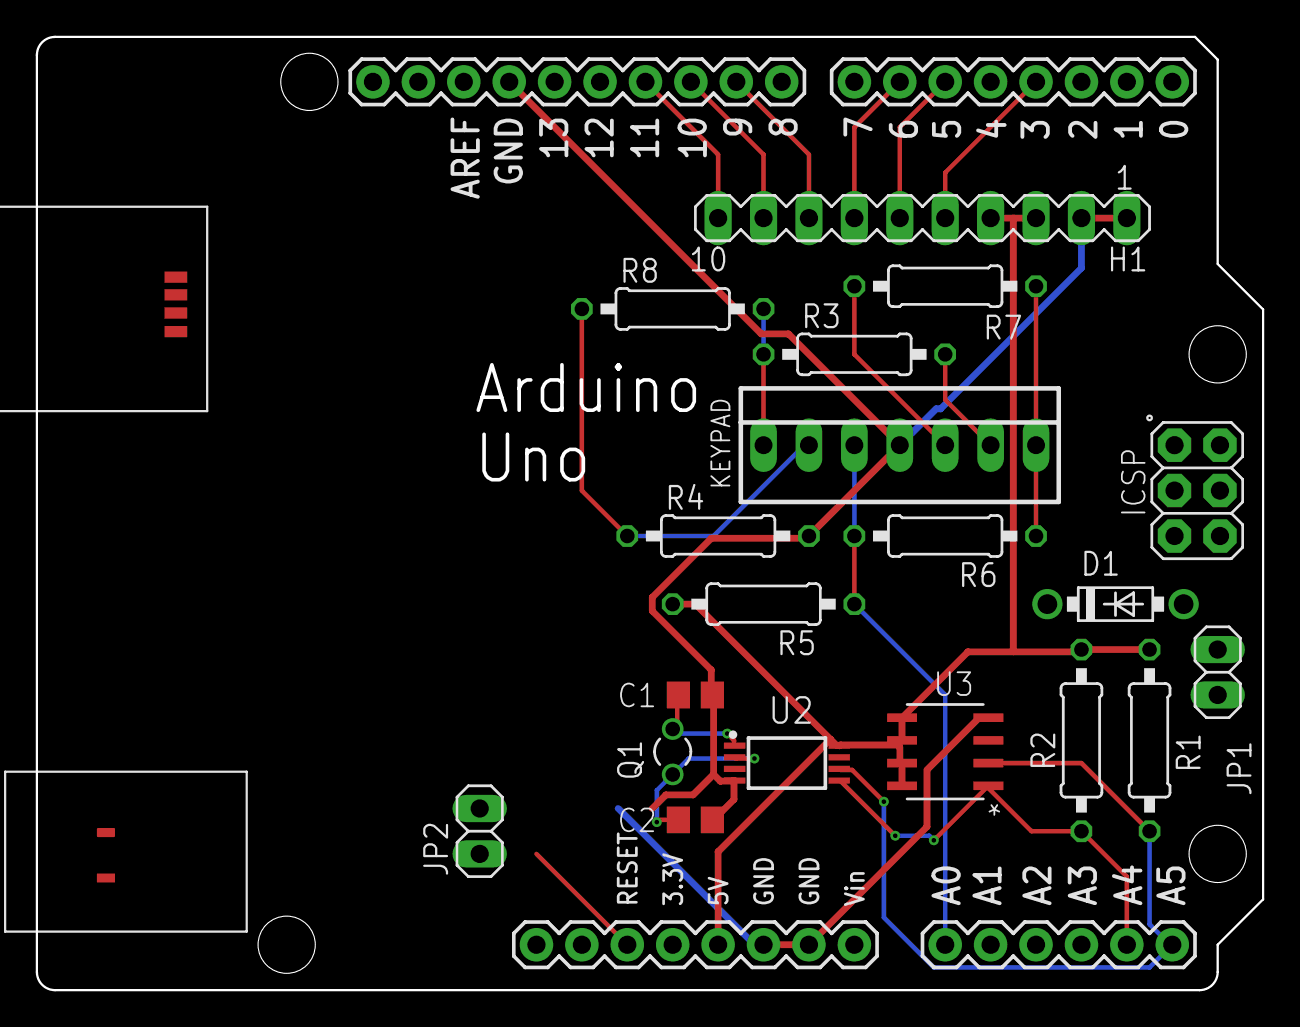
[picture p31: board FireflyShield.brd from above]

Board: 2 copper layers, 68.6 x 53.3 mm, 19 parts (0 on the bottom side), 21 nets.
