kjoehass/firefly/code/Firefly.h

/**
   @file Firefly.h

   @brief  Global configuration options for the firefly simulator

   @author Joe Hass and Matt Turconi
   @date Created: 2019-04-14T10:51:46-0400
   @date Last modified: 2019-09-04T08:05:27-0400

   @copyright This program is free software: you can redistribute it and/or
   modify it under the terms of the GNU General Public License as published by
   the Free Software Foundation, either version 3 of the License, or (at your
   option) any later version.

   @copyright This program is distributed in the hope that it will be useful,
   but WITHOUT ANY WARRANTY; without even the implied warranty of
   MERCHANTABILITY or FITNESS FOR A PARTICULAR PURPOSE. See the GNU General
   Public License for more details.

*/
#ifndef _FIREFLY_H
#define _FIREFLY_H

/**
  @def   ARDUINO_IS_UNO
  @brief Compile for an UNO with 6 PWM channels and 2KiB EEPROM
*/
#define ARDUINO_IS_UNO  1
#define ARDUINO_IS_MEGA 0

/**
  @def   HUMAN_READABLE_MSGS
  @brief If true, print more verbose messages

  Response messages can be send in human-readable or machine-readable form.
  Human-readable messages print meaningful identifiers for all of the fields
  in a message, but the machine-readable messages have a single, lower-case
  character as the first character and then all fields are numbers separated
  by commas (i.e. a csv format).
*/
#define HUMAN_READABLE_MSGS = 1

/**
  @var   Channel2Pin
  @brief Global array that maps PWM 'channel' to Arduino 'pin'
*/
extern const int Channel2Pin[];

#include "ConfigData.h"

/**
  @var   ld
  @brief Global variable holding the "current" LED definition
*/
extern LED ld;
/**
  @var   fl
  @brief Global variable holding the "current" flash definition
*/
extern Flash fl;
/**
  @var   pt
  @brief Global variable holding the "current" pattern definition
*/
extern Pattern pt;
/**
  @var   rd
  @brief Global variable holding the "current" random pattern set definition
*/
extern RandPatternSet rd;

#endif
