kjoehass/firefly/(commit log)

2019-04-11 Fixed Flash Pattern Interval
    [ExeMsg.cpp]
2019-04-17 Added FAKE_RTC macro in case RTC is absent
2019-04-17 Use ARDUINO_IS_UNO to set MaxChannel Change DisplayLED, DisplayFlash, DisplayPattern to just Display Store virtual channel number as LED::Channel, not pin number Display functions use HUMAN_READABLE_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
2019-04-17 Fixed typo in RealTimeClock comments
    [RealTimeClock.cpp]
2019-04-23 Virtual LED Channel Correction
    [ConfigMsg.cpp, ConfigMsg.h, ExeMsg.cpp]
2019-04-25 First version of shield schematic and PCB
    [FireflyShield.brd, FireflyShield.sch]
2019-04-26 Better symbols/footprints for LM75, MCP79400
    [FireflyShield.brd, FireflyShield.sch]
2019-04-30 Add RTC battery connection
    [FireflyShield.brd, FireflyShield.sch]
2019-05-01 Added hardware design files
    [ConstCurrPTH.brd, ConstCurrPTH.sch, DRILEGEND.CFG, FireflyShield.brd, FireflyShield.sch, RJ11Breakout.brd, RJ11Breakout.sch]
2019-05-06 Added datasheets and OSHPark board images
2019-05-19 Fix Pattern::Display, add Execute functions
    [ConfigData.cpp, ConfigData.h]
2019-05-19 Fixed definition/declaration of objects, added keypad
    [Firefly.h]
2019-05-19 Added RandomPattern support, fixed declarations
    [ConfigMsg.cpp, ConfigMsg.h]
2019-05-23 Fixed Flash Exe Fuction
    [ExeMsg.cpp]
2019-05-31 Added support for Capacity Response Message
2019-06-19 Fixed wire color order on LED board
    [ConstCurrPTH_V1.brd, ConstCurrPTH_V1.sch]
2019-06-19 First commit of gui code
    [somefile.csv]
2019-06-20 Fixed pattern.dump() (missing IPI)
    [firefly_data.py]
2019-07-03 Added update_config() call when frame changes
2019-07-03 Added update_config(), fixed on_move()
    [flash_config.py]
2019-07-03 Fix handling of flash radio buttons
    [patt_config.py]
2019-07-03 Added FPI value to pattern lines
    [somefile.csv]
2019-07-03 Added on_tosim(), fixed on_tofile()
    [startpage.py]
2019-07-22 Added LED configuration frame
2019-07-22 Added frame to configure LEDs
2019-07-29 Changes kept or discarded. Spinboxes for patterns
    The code keeps track (crudely) of when an LED, flash, or pattern
    as been modified. The user is required to explicitly keep or
    discard any changes before beginning to edit a different LED, flash,
    or pattern.
    Spinboxes are used to select the flashes in a pattern, rather than
    two sets of radiobuttons.
2019-08-06 Cleaned comments, added Execute frame
    Some comments, docstrings, and indenting were cleaned up after
    running pylint. The Execute frame was added to execute an LED,
    a flash, a pattern, or a pattern set. The Startpage functions
    were modified to explicitly close the serial connection. Startpage
    was also modified to handle the "Cancel" buttons of the file
    selection dialog boxes.
2019-08-19 Fixed formatting for Arduino IDE
    [AnalogKeypad.cpp, RealTimeClock.cpp, RealTimeClock.h]
2019-08-19 Changed comment blocks to Arduino IDE style
2019-09-22 Add serial print to Pattern::Execute, minor cleanups
2020-07-17 Added files for lasercutting the wood box
2020-08-04 Improve flash timing, random patterns, keypad
    ExeMsg.cpp Calls LED.setLevel() to set illumination, does not set
    pinMode for PWM pins (moved to setup).
    Removed flash_led() (moved to fl.Execute())
    exec_flash() simplified, uses fl.Execute()
    exec_pattern() simplified, uses pt.Execute()
    Removed gen_rand_flash()...random pattern code was never
    correct
    Modified exec_random_pat() to correctly get the list of
    patterns from EEPROM
    ExeMsg.h Removed flash_led() and gen_rand_flash()
    Firefly.h Added comments
    codeTemp.ino Added comments
    Defined global datastructures for LED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
    [ExeMsg.cpp, ExeMsg.h, Firefly.h, code.ino]
2021-01-25 Add pdf version of schematic
2021-01-26 Improved information messages for Arduino comms
2021-01-26 Fixed code that sets year in Arduino RTC
    [arduino_config.py]
2021-01-26 First README for the Arduino code
2021-04-15 Fixed config of PWM pins in setup()
    [code.ino]
2021-04-15 Changed error message in exec_led()
    [ExeMsg.cpp]
2021-04-15 Fixed bug in config_LED()
    Bug would not allow channel 6 or LED 16 to be used.
    [ConfigMsg.cpp]
