kjoehass/firefly/(notices)

Notices in the files:
parts and their libraries:
Wurth_Elektronik_Electromechanic_Input-O: Copyright: Würth Elektronik
